BenKohn2004/Target_Practice/Target Enclosure.png

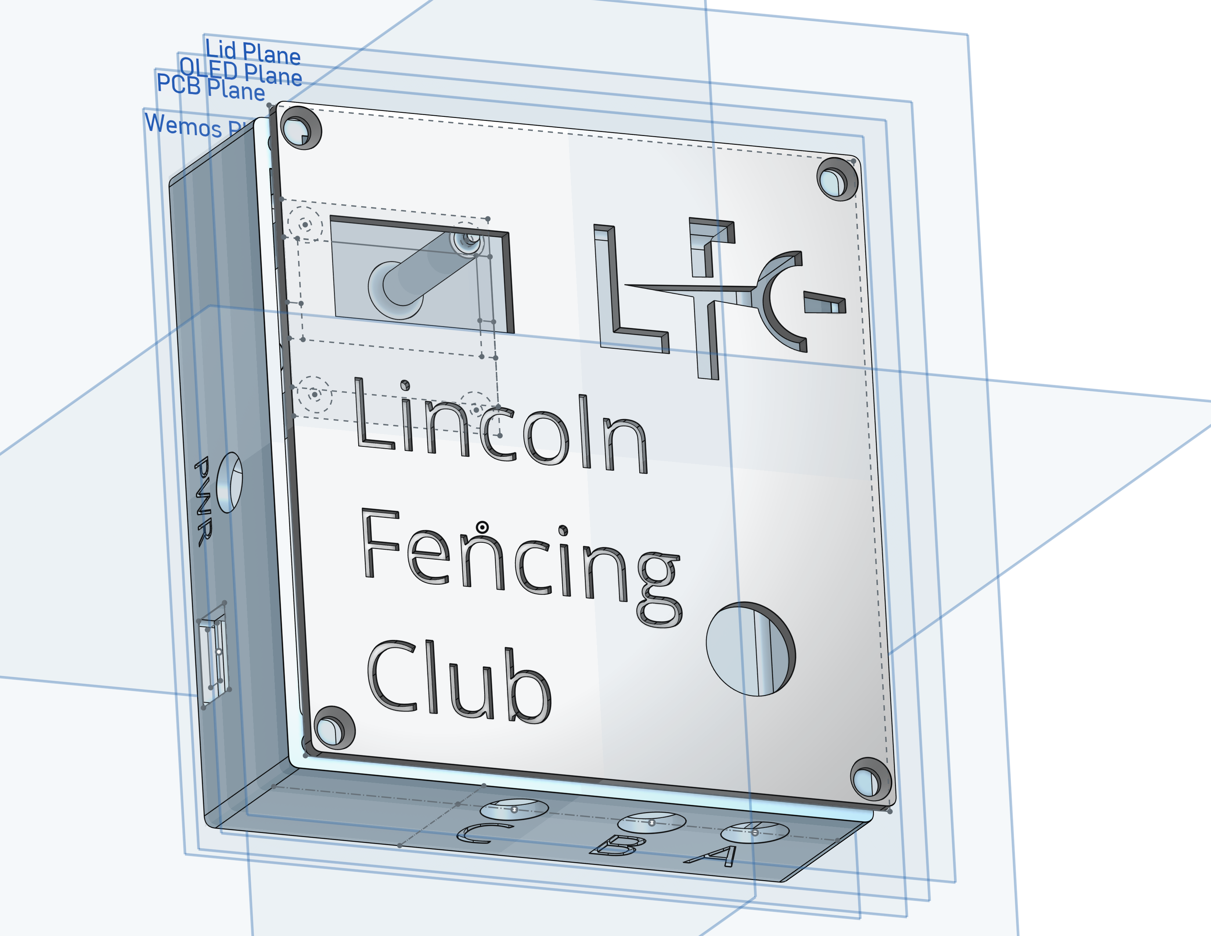
Target Enclosure.png
