BenKohn2004/Target_Practice/Schematic_Fencing_Target_Individually_Addresseable.pdf

A | A

## WEMOS-D1-MINI

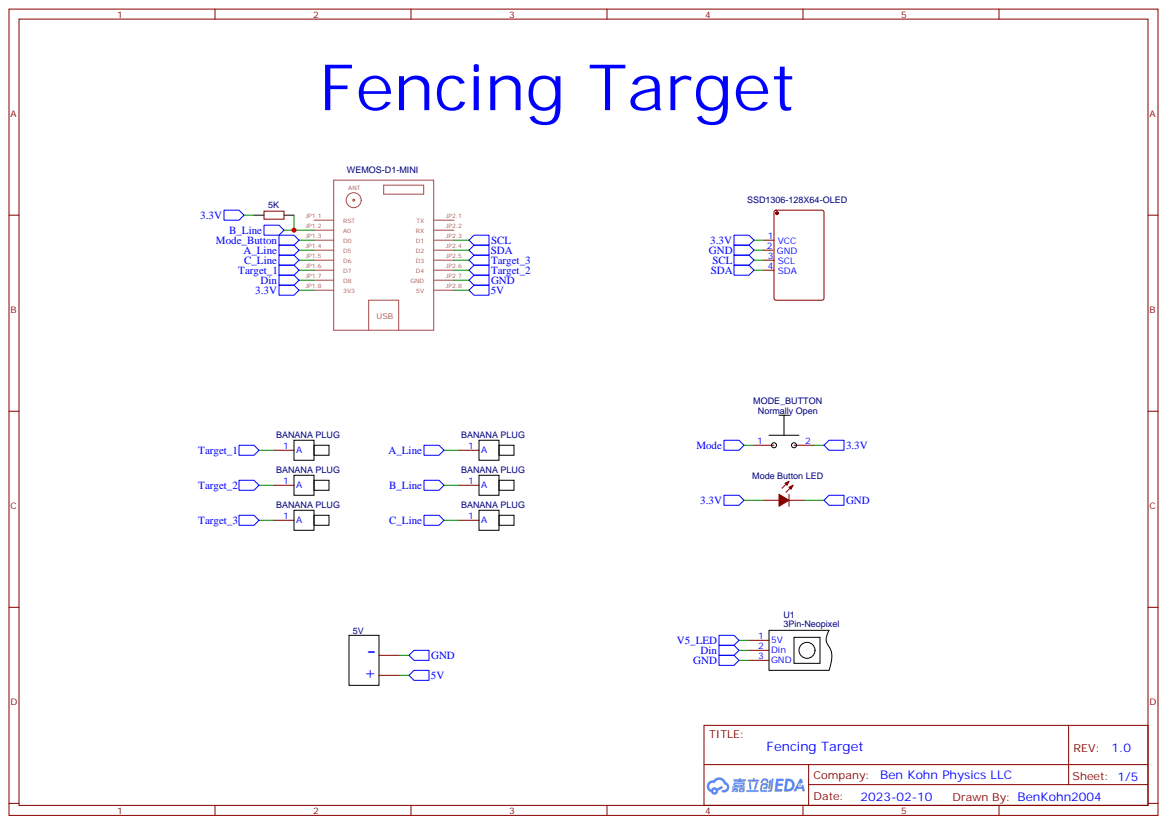
[picture p2: page 1]

Company: Ben Kohn Physics LLC

A | A

## WEMOS-D1-MINI-PRO

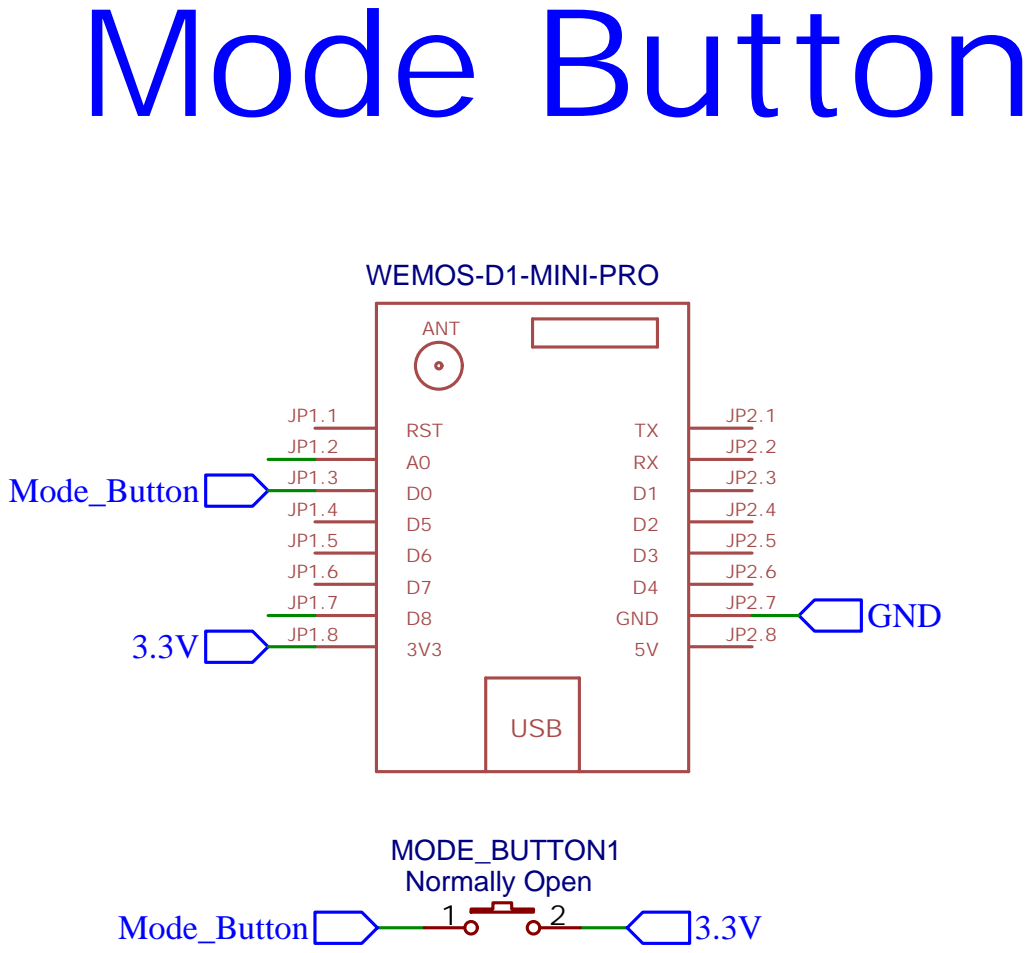
[picture p3: page 2]

A | A

## B_Line

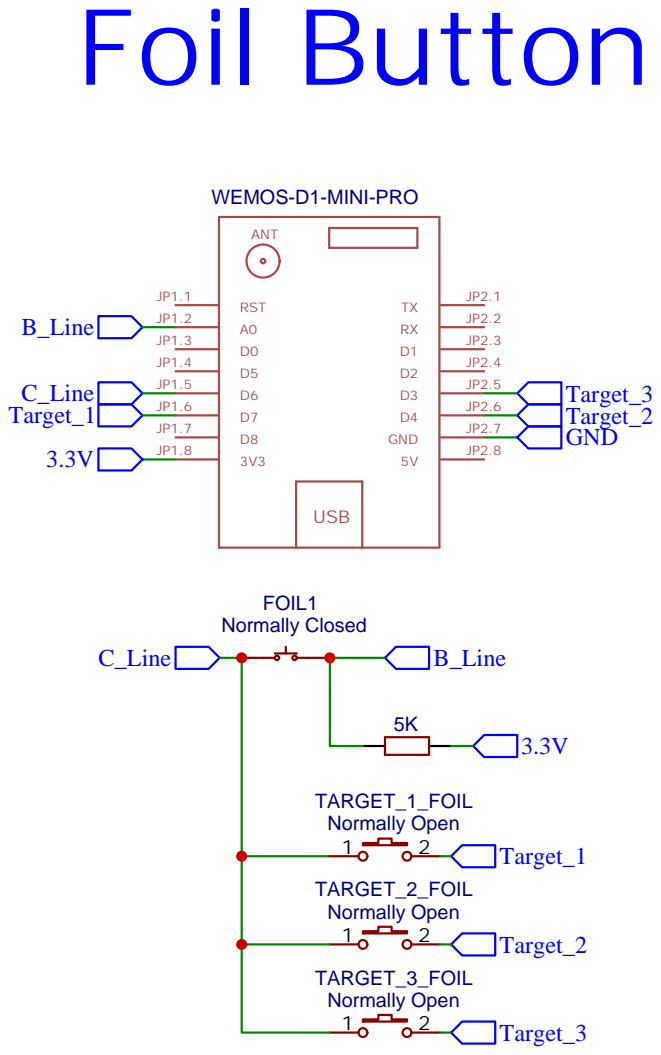
[picture p4: page 3]

A | A

## WEMOS-D1-MINI-PRO

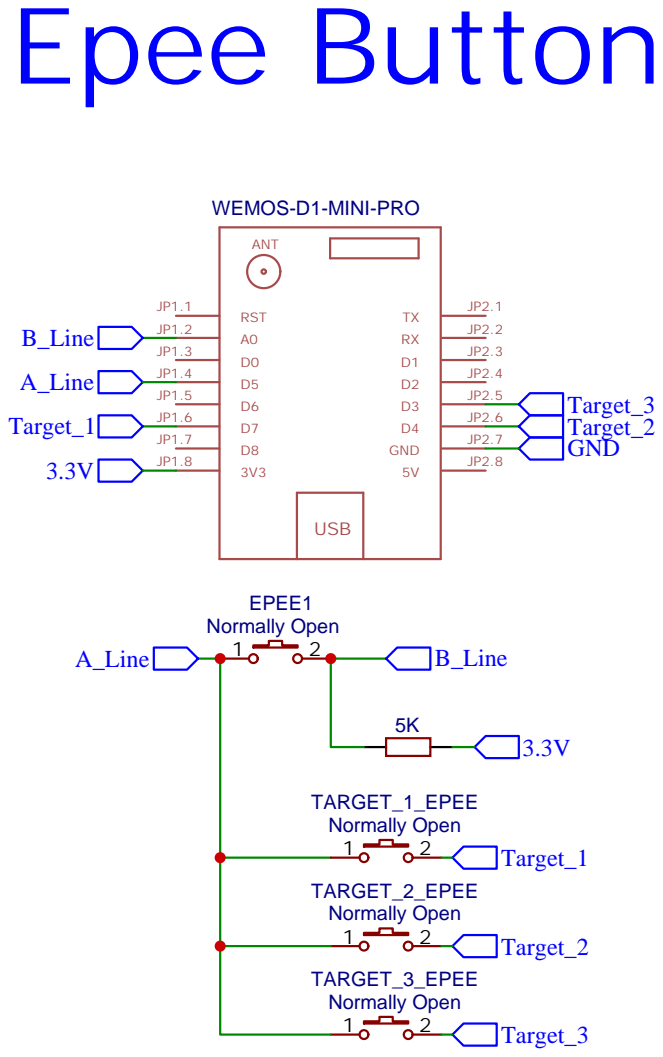
[picture p5: page 4]

A | A

# Saber Button

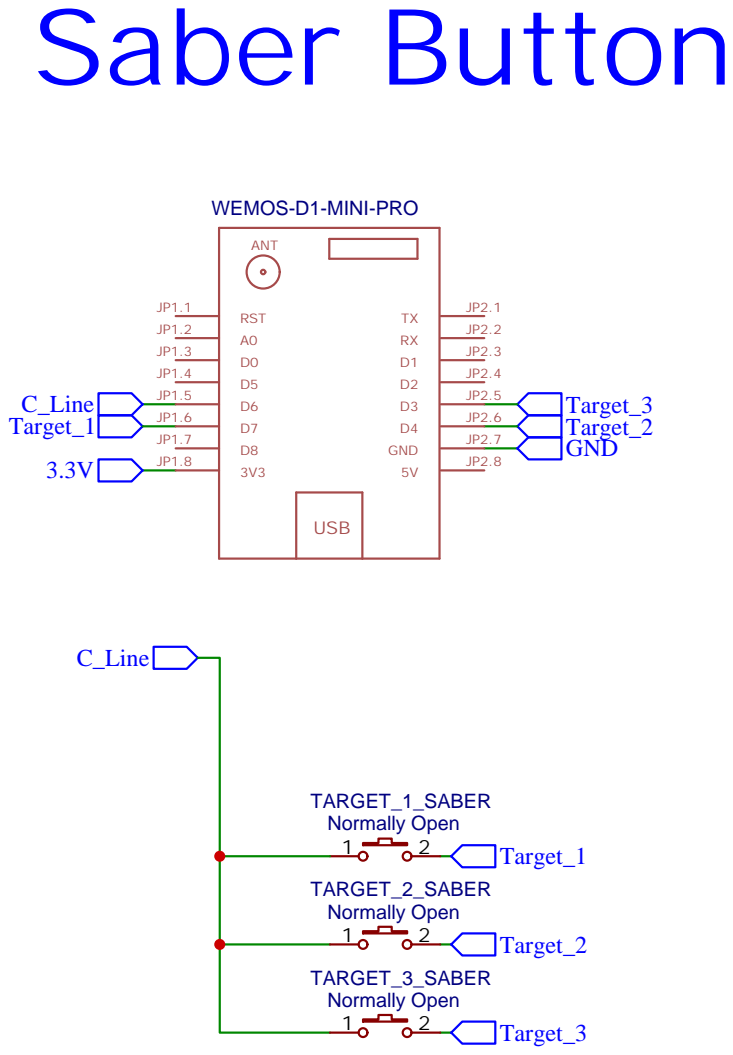
[picture p6: page 5]
