BenKohn2004/Target_Practice/(commit log)

2023-05-12 Add files via upload
    Initial Commit. Schematic of Wemos Fencing Target
2023-06-01 Used micros()
    Used micros() in place of millis() for Saber Debounce, lowered saber debounce to 100 micros()
